LukaszSztuka/Projektowanie-ukladow-elektronicznych/eagle/OpenLab/OpenLabKostkaSchemat.pdf

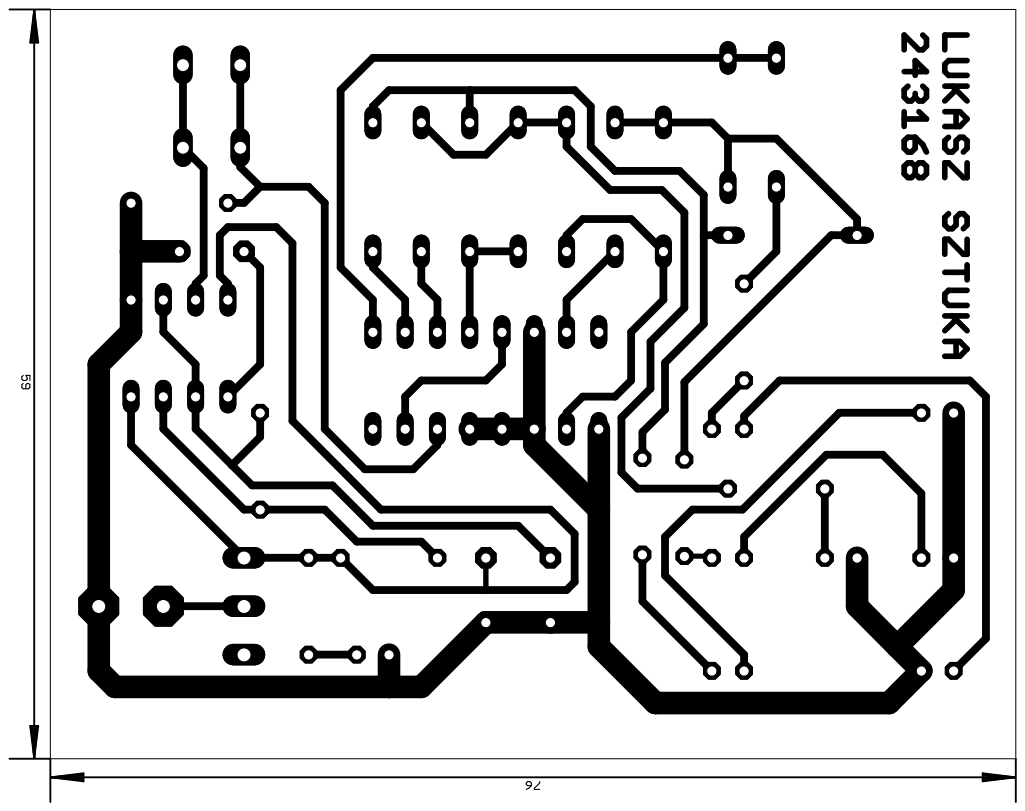
[picture p14: page 1]
