LukaszSztuka/Projektowanie-ukladow-elektronicznych/LTSpice/Kostka.asc

C1: cap; 100n
C2: cap; 100n
C3: cap; 100n
D1: diode; 1N4148
D2: diode; 1N4148
D3: diode; 1N4148
D4: diode; 1N4148
D5: diode; 1N4148
D6: diode; 1N4148
D7: diode; 1N4148
D8: diode; 1N4148
D9: diode; 1N4148
D10: LED
D11: LED; QTLP690C
D12: LED; QTLP690C
D13: LED; QTLP690C
D14: LED; QTLP690C
D15: LED; QTLP690C
D16: LED; QTLP690C
D17: LED; QTLP690C
R1: res; 1.2k
R2: res; 220
R3: res; 1.2k
R4: res; 1.5k
R5: res; 1.8k
R6: res; 2.2k
R7: res; 2.7k
R8: res; 15k
S1: sw
U1: CD4017B; VDD=9  SPEED=1.0  TRIPDT=5e-9
U2: NE555
V1: voltage; 9
V2: voltage; PULSE(0 1 0 10n 10n 100u 1m)
Named nets: 0, Vcc, CLK, R, PRZYCISK
.tran 10m startup
.lib CD4000.lib
.model SW SW(Ron=10 Roff=1e6 Vt=.5 Vh=-0.4
