LukaszSztuka/Projektowanie-ukladow-elektronicznych/eagle/OpenLab/OpenLabKostkaSchemat.brd

## EAGLE design eagle/OpenLab/OpenLabKostkaSchemat.brd (2022-03-09)

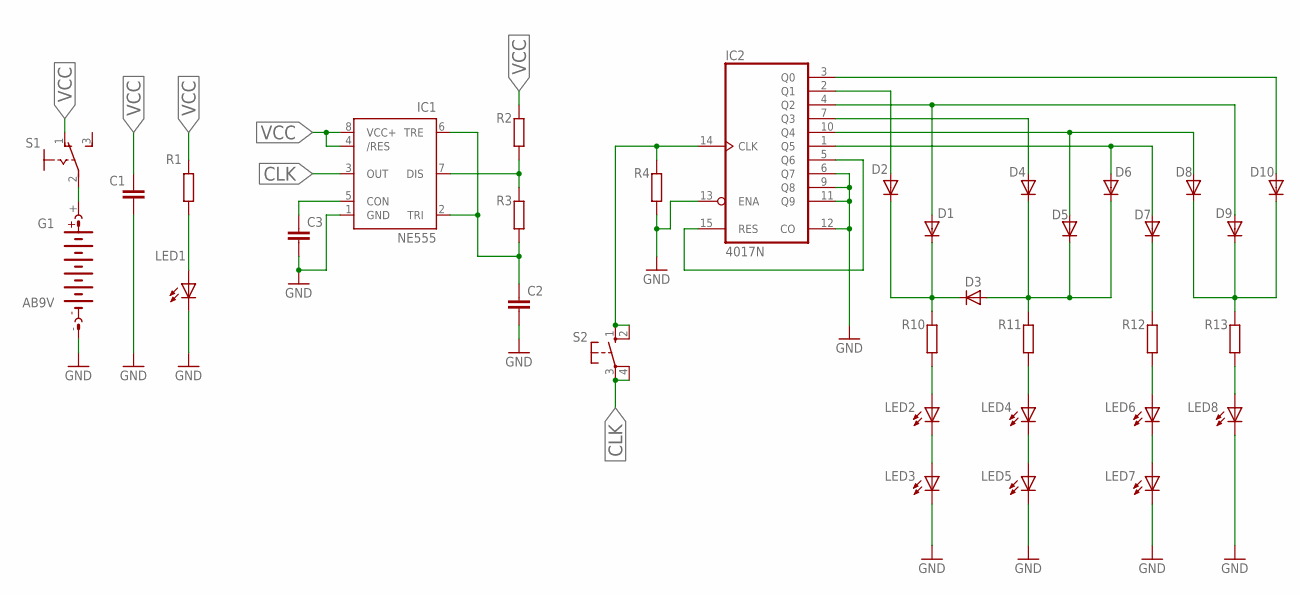
[picture p15: schematic OpenLabKostkaSchemat.sch]

Parts:
C1, C2, C3: C5/2.5; C5B2.5
D1, D2, D3, D4, D5, D6, D7, D8, D9, D10: 1N4446; DO35-10
G1: AB9V
IC1: NE555; DIL-08
IC2: 4017N; DIL16
LED1, LED2, LED3, LED4, LED5, LED6, LED7, LED8: LED_ELD260; LED_LD260
R1, R2, R3, R4, R10, R11, R12, R13: R0204/7; 0204/7
S1: 255SB
S2: 10-XX; B3F-10XX

Connections:
CLK: IC1.3 (OUT), S2.3, S2.4 (P1)
GND: C1.1, C2.2, C3.2, G1.-, IC1.1 (GND), IC2.6 (Q7), IC2.9 (Q8), IC2.11 (Q9), IC2.12 (CO), IC2.13 (ENA), LED1.K (C), LED3.K (C), LED5.K (C), LED7.K (C), LED8.K (C), R4.1
unnamed: C2.1, IC1.2 (TRI), IC1.6 (TRE), R3.1
unnamed: IC2.14 (CLK), R4.2, S2.1 (S), S2.2 (S1)
unnamed: LED2.K (C), LED3.A
unnamed: IC1.7 (DIS), R2.1, R3.2
unnamed: D8.C, D9.C, D10.C, R13.2
unnamed: LED4.K (C), LED5.A
unnamed: LED6.K (C), LED7.A
unnamed: D10.A, IC2.3 (Q0)
unnamed: G1.+, S1.2
unnamed: D2.A, IC2.2 (Q1)
unnamed: LED1.A, R1.1
unnamed: LED8.A, R13.1
unnamed: LED6.A, R12.1
unnamed: LED4.A, R11.1
unnamed: LED2.A, R10.1
unnamed: D7.C, R12.2
unnamed: D3.A, D4.C, D5.C, D6.C, R11.2
unnamed: C3.1, IC1.5 (CON)
unnamed: D1.A, D9.A, IC2.4 (Q2)
unnamed: IC2.5 (Q6), IC2.15 (RES)
unnamed: D4.A, IC2.7 (Q3)
unnamed: D5.A, D8.A, IC2.10 (Q4)
unnamed: D6.A, D7.A, IC2.1 (Q5)
unnamed: D1.C, D2.C, D3.C, R10.2
VCC: C1.2, IC1.4 (/RES), IC1.8 (VCC+), R1.2, R2.2, S1.1 (O)
VDD: IC2.16 (VDD)
VSS: IC2.8 (VSS)

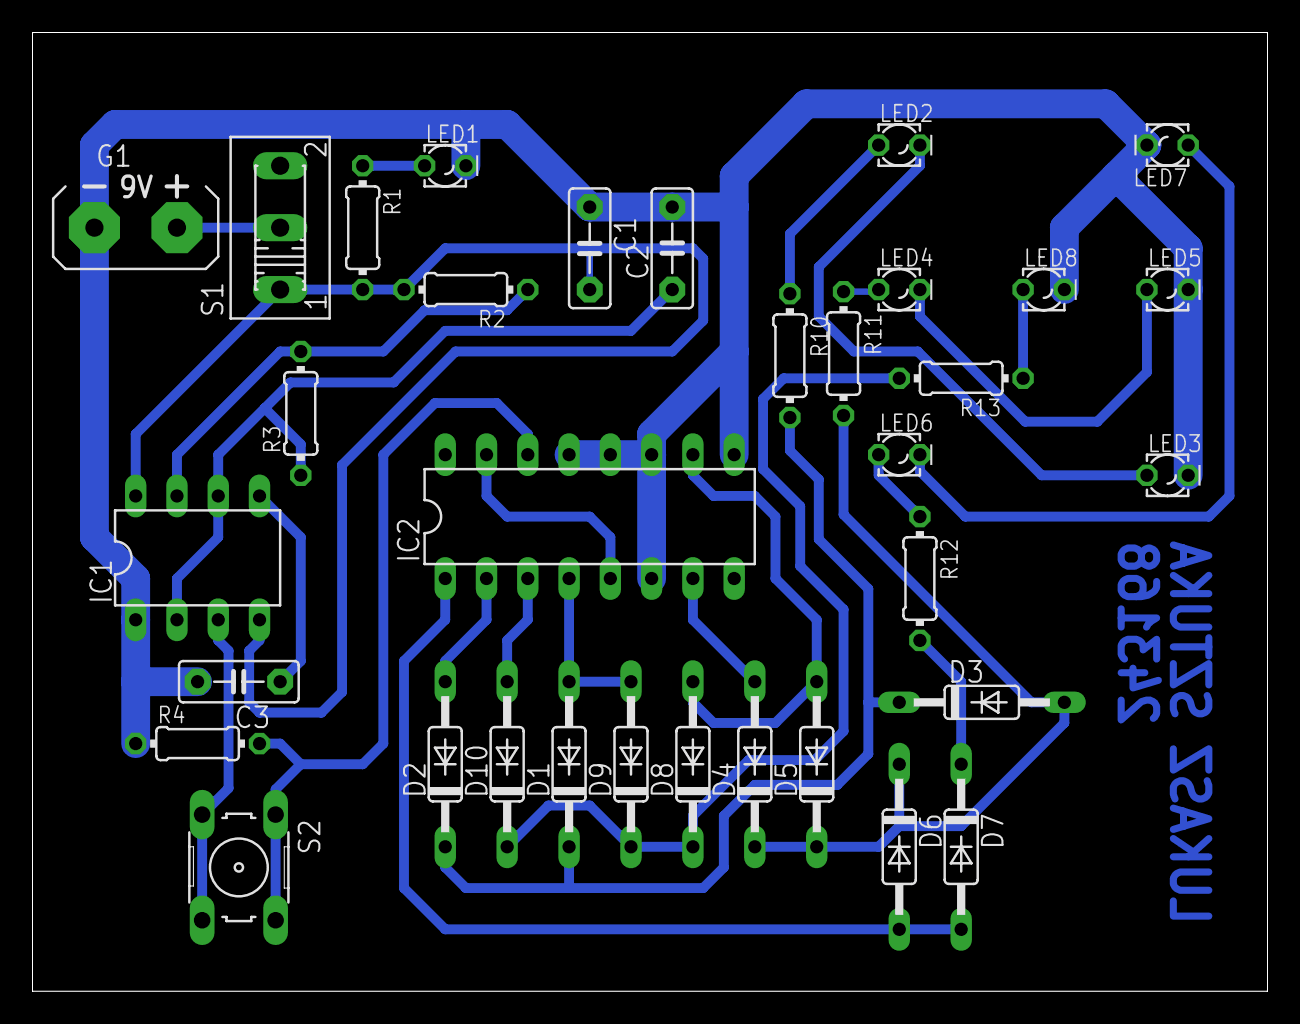
[picture p16: board OpenLabKostkaSchemat.brd from above]

Board: 2 copper layers, 76.0 x 59.0 mm, 34 parts (0 on the bottom side), 27 nets.
